Neurotech-Hub/ACORN/brand/ANCORN_render_back.png

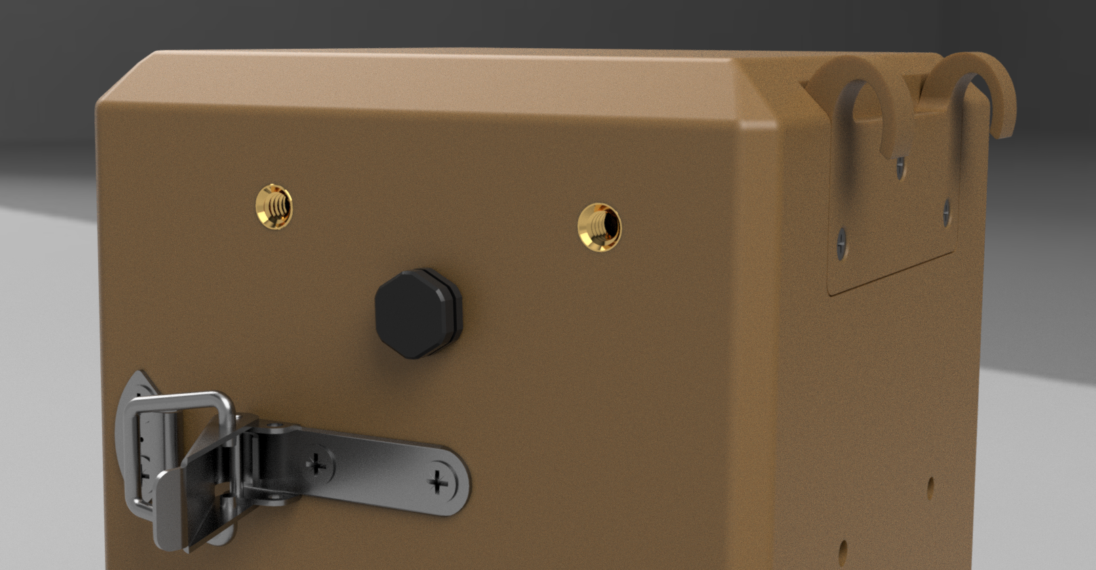
brand/ANCORN_render_back.png
