Neurotech-Hub/ACORN/brand/ACORN_iphone_rustic_mockup.jpg

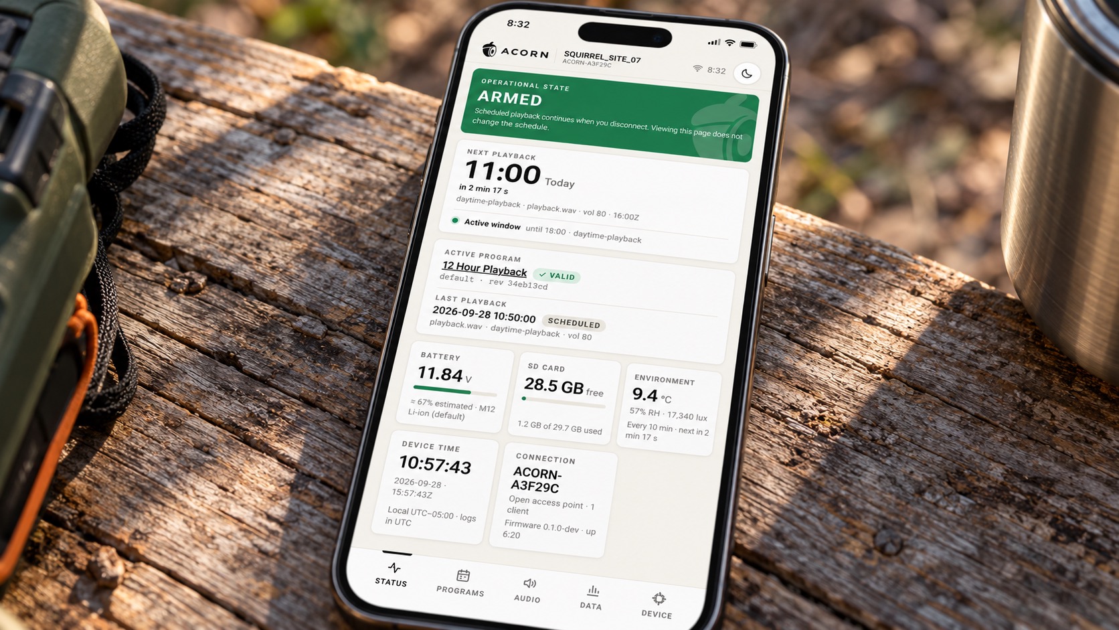
brand/ACORN_iphone_rustic_mockup.jpg
