Neurotech-Hub/ACORN/docs/assets/acorn-spl-levels.pdf

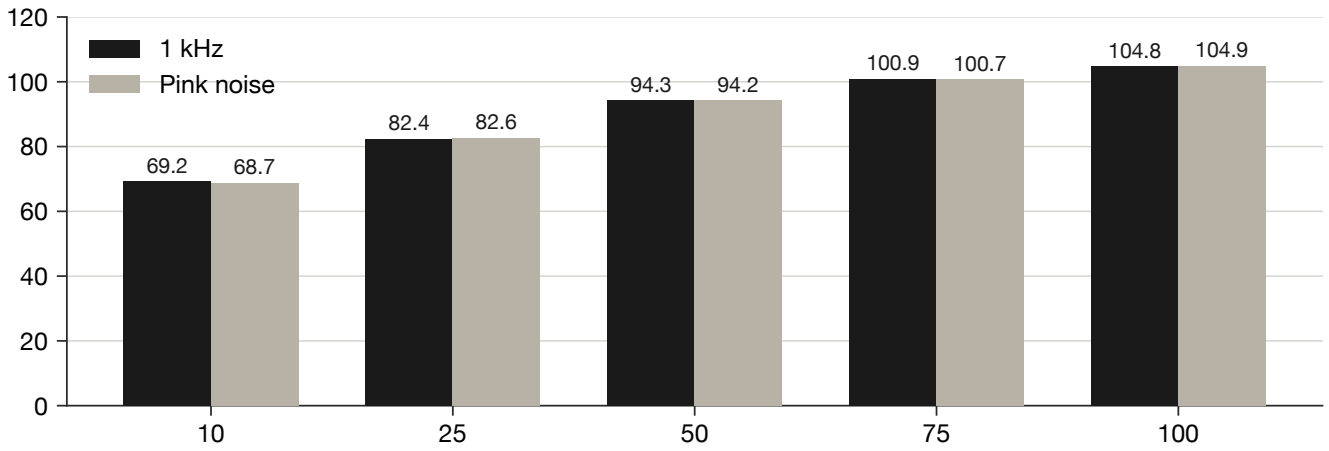
[picture p3: figure]
1 kHz Pink noise

## Volume

## Maximum SPL (dB)

## ACORN | Sound Pressure Level
