Neurotech-Hub/ACORN/brand/ACORN_brandKit.png

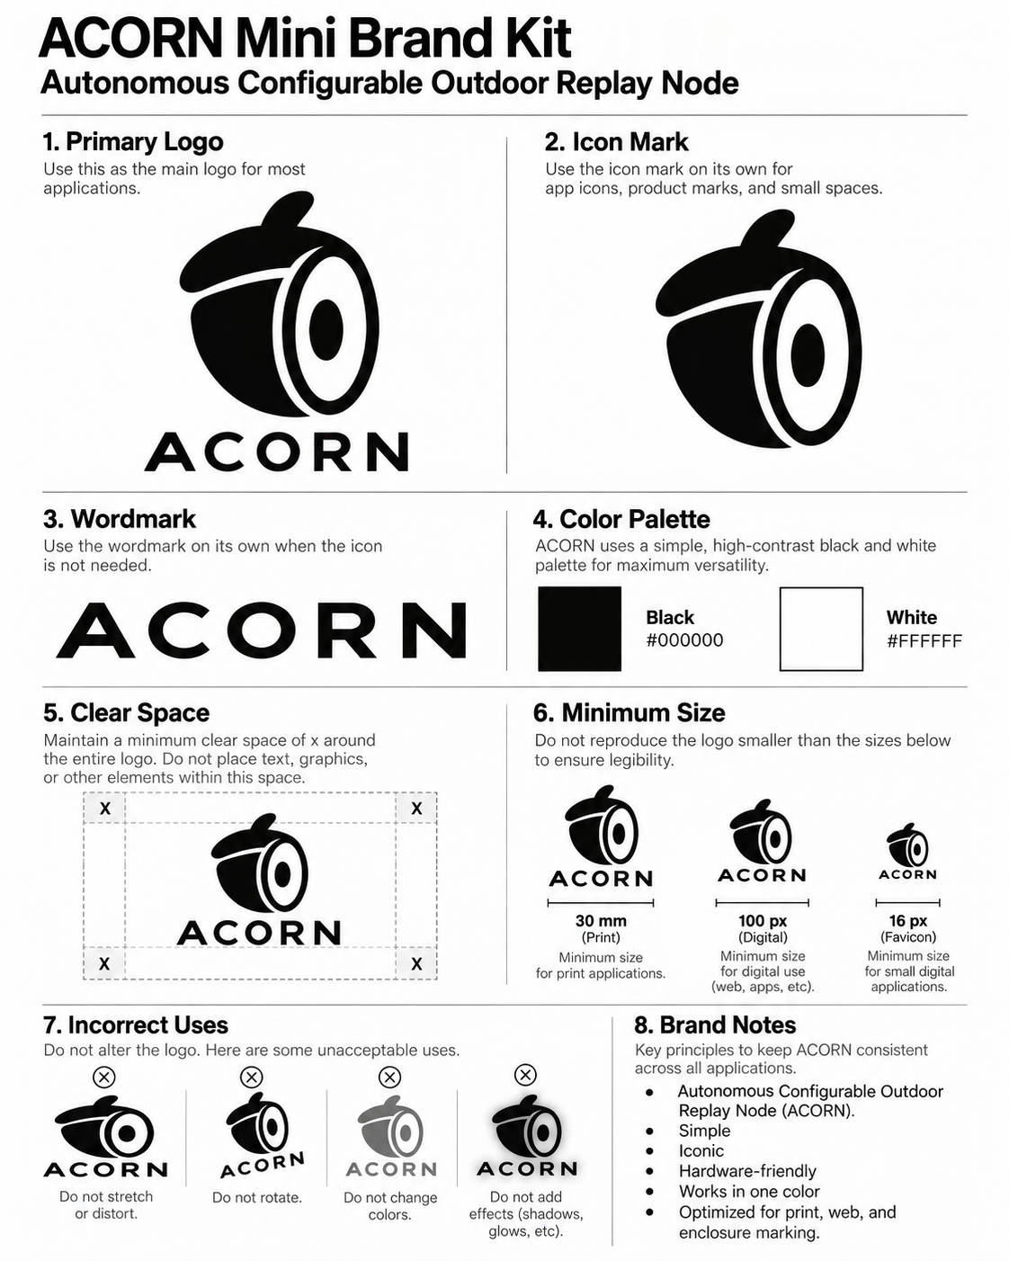
brand/ACORN_brandKit.png
