Neurotech-Hub/ACORN/brand/ACORN_iphone_mockup.jpg

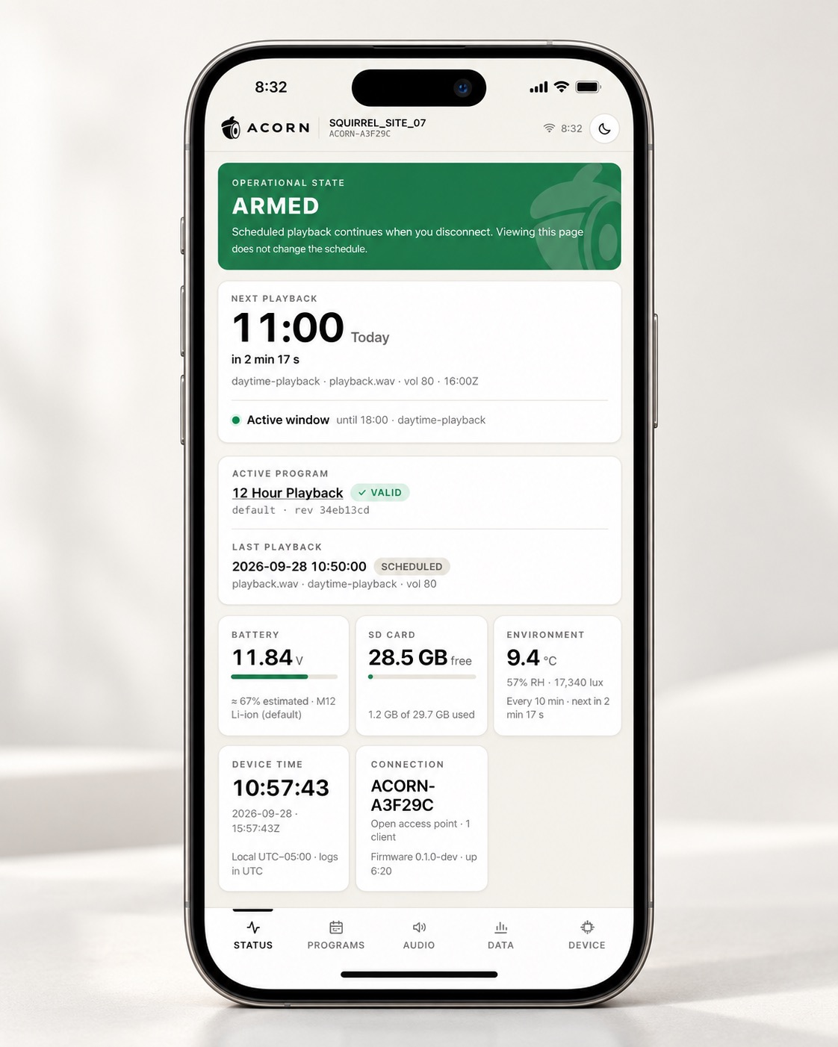
brand/ACORN_iphone_mockup.jpg
