Neurotech-Hub/ACORN/brand/ACORN_iphone_treemount_mockup.jpg

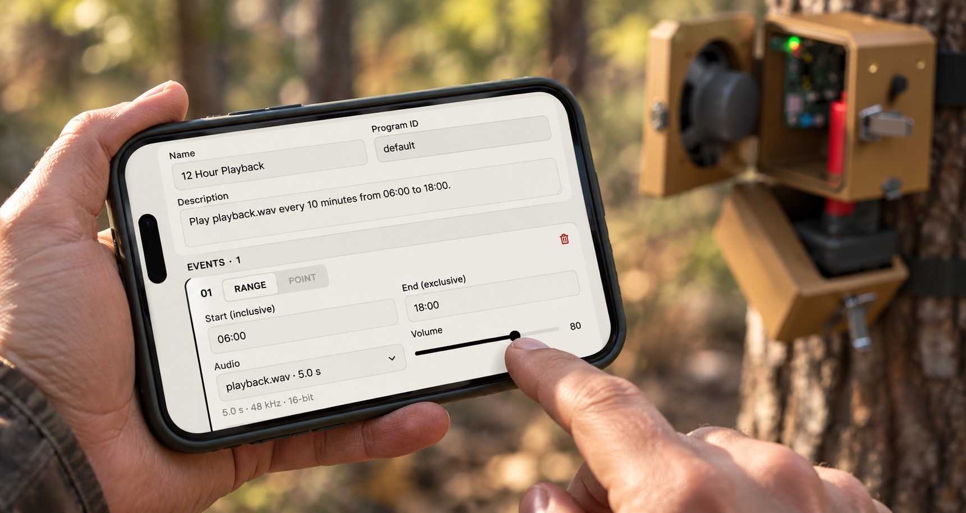
brand/ACORN_iphone_treemount_mockup.jpg
