Neurotech-Hub/ACORN/brand/ACORN_macbook_mockup.jpg

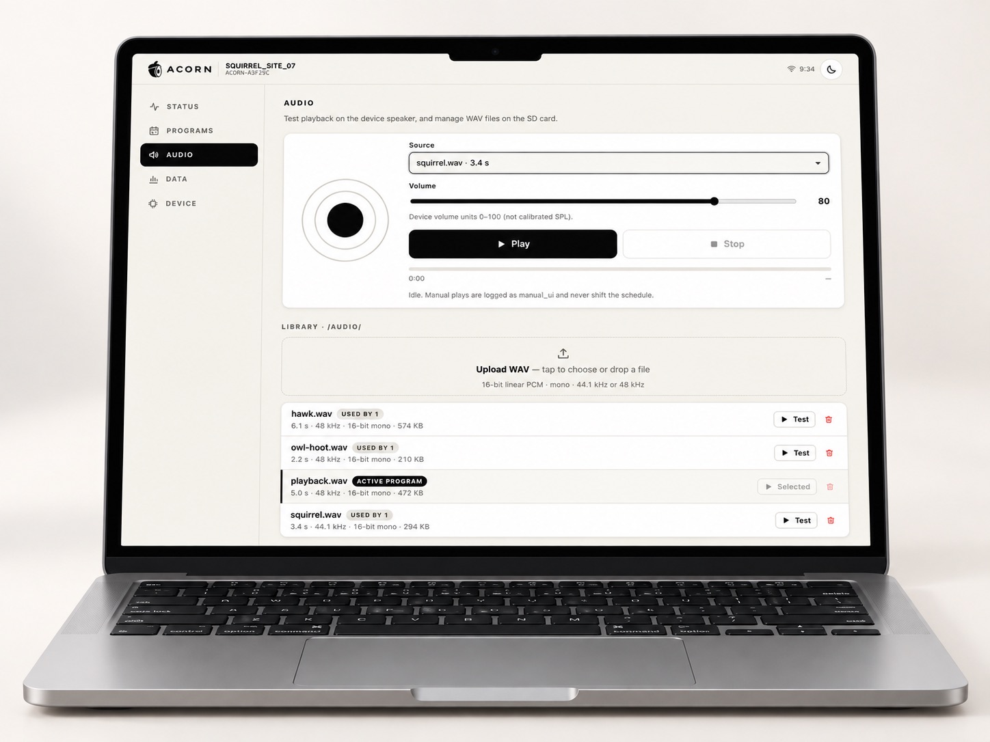
brand/ACORN_macbook_mockup.jpg
