Neurotech-Hub/ACORN/brand/ACORN_render_front.png

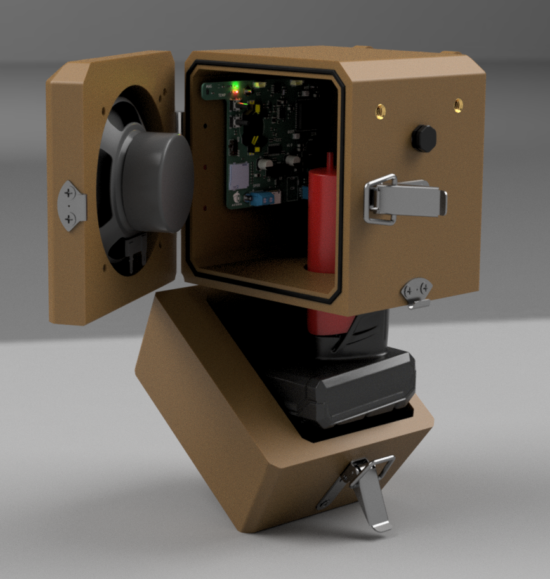
brand/ACORN_render_front.png
