Neurotech-Hub/ACORN/docs/assets/acorn-frequency-response.png

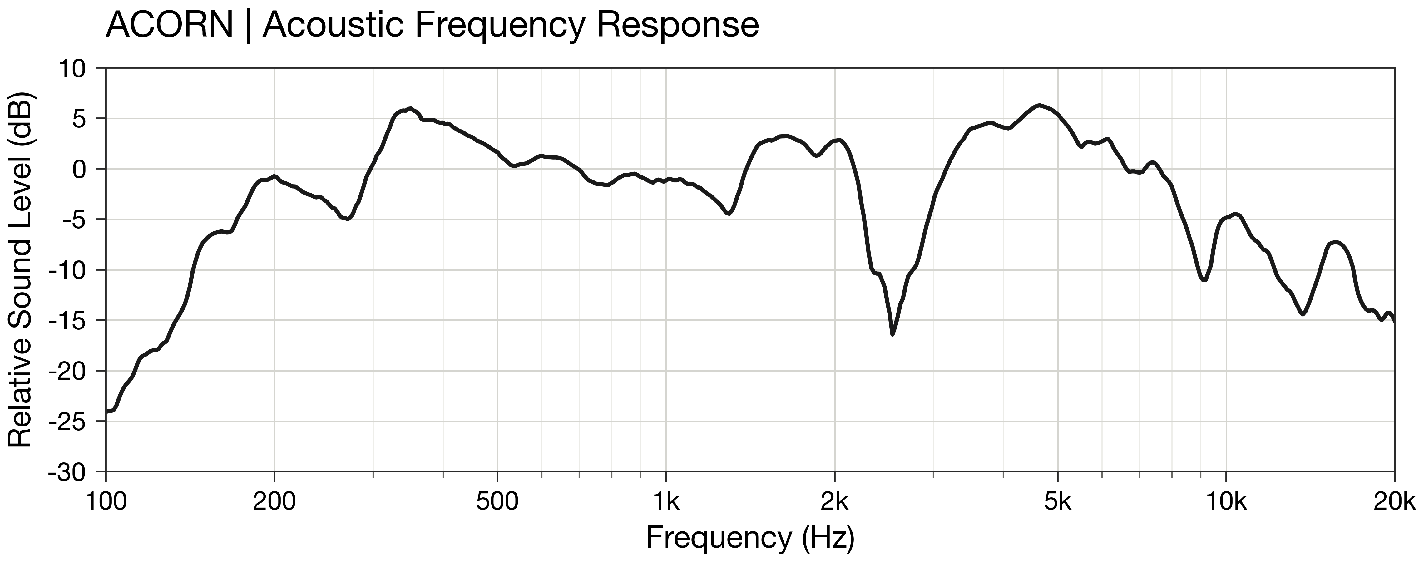
docs/assets/acorn-frequency-response.png
