Neurotech-Hub/ACORN/docs/assets/acorn-spl-levels.png

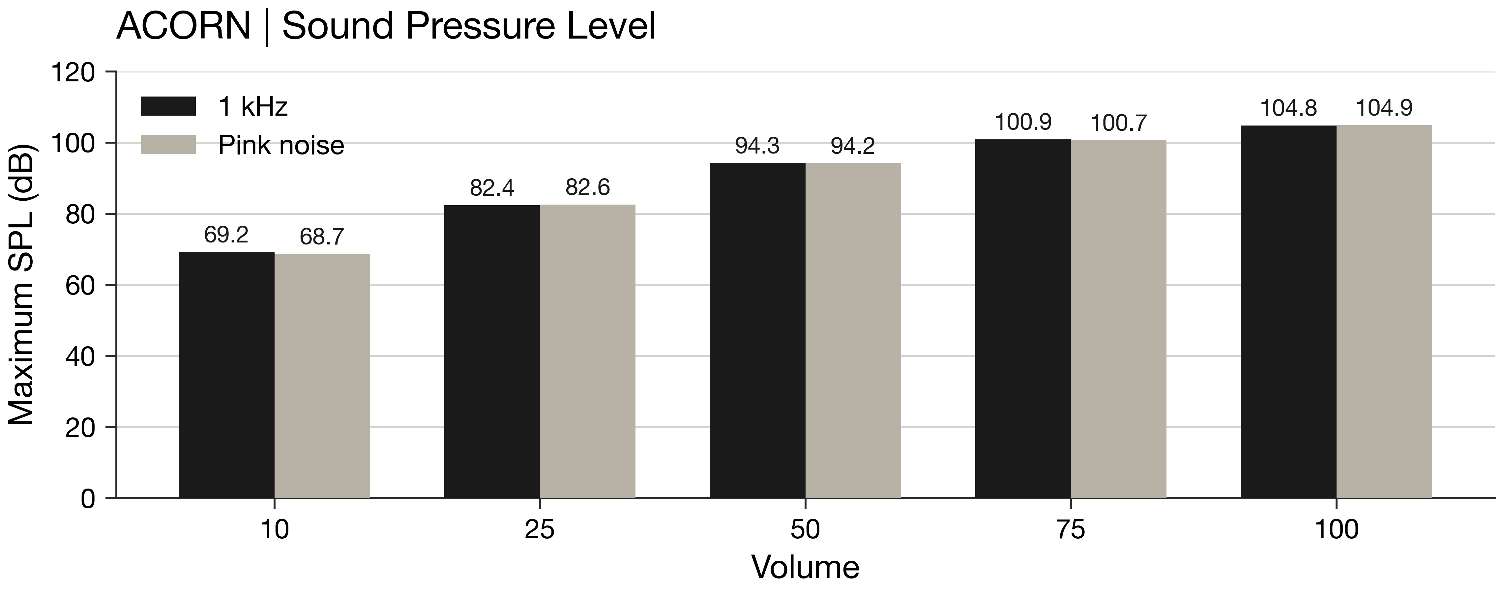
docs/assets/acorn-spl-levels.png
