Neurotech-Hub/ACORN/docs/sweep/media/mg-2026-10-28-12.03.54_v75.png

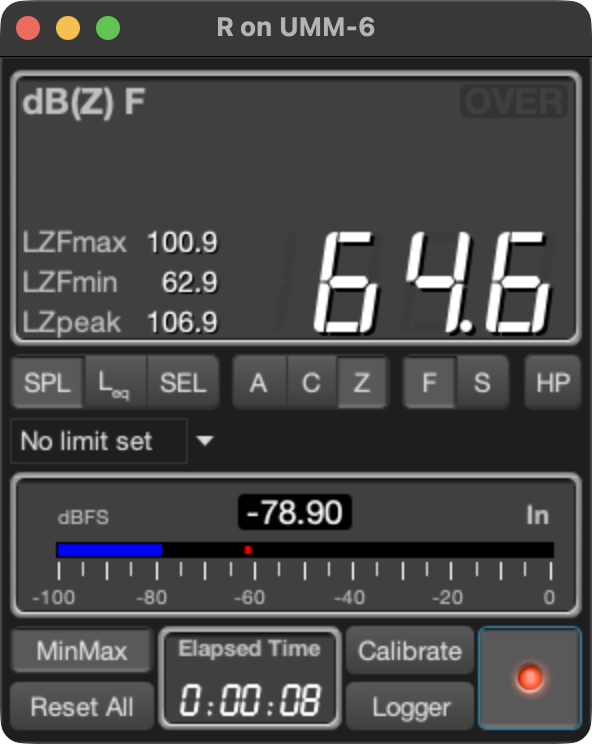
docs/sweep/media/mg-2026-10-28-12.03.54_v75.png
