Neurotech-Hub/ACORN/docs/sweep/media/mg-2026-10-28-12.04.52_v25.png

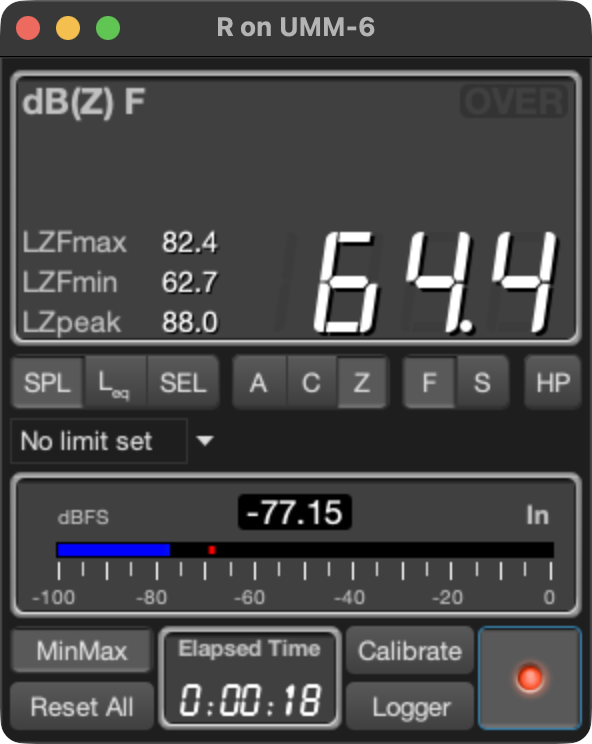
docs/sweep/media/mg-2026-10-28-12.04.52_v25.png
