Neurotech-Hub/ACORN/docs/sweep/media/mg-2026-10-28-12.07.01_pink_v10.png

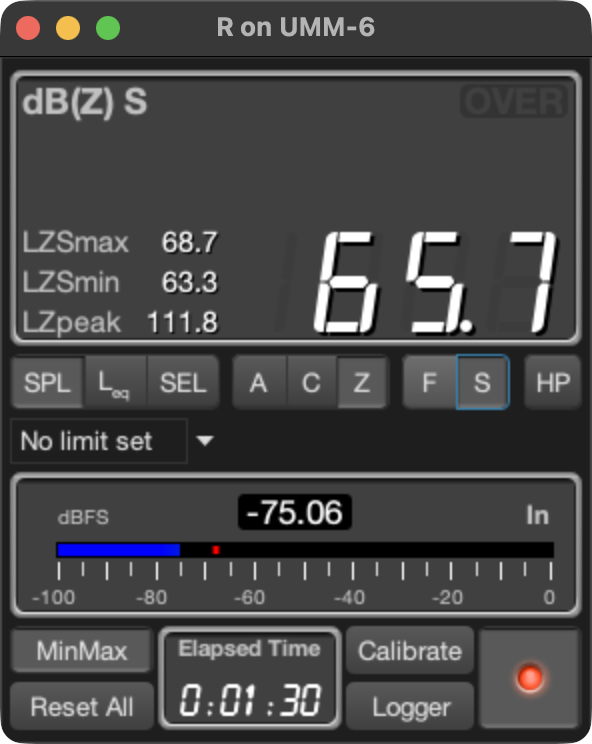
docs/sweep/media/mg-2026-10-28-12.07.01_pink_v10.png
