Neurotech-Hub/ACORN/docs/sweep/media/mg-2026-10-28-12.07.39_pink_v25.png

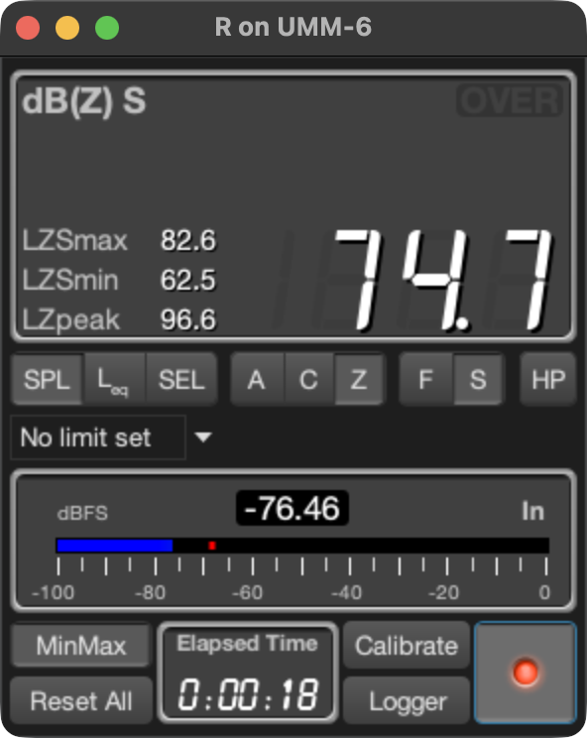
docs/sweep/media/mg-2026-10-28-12.07.39_pink_v25.png
