Neurotech-Hub/ACORN/docs/sweep/media/mg-2026-10-28-12.08.13_pink_v50.png

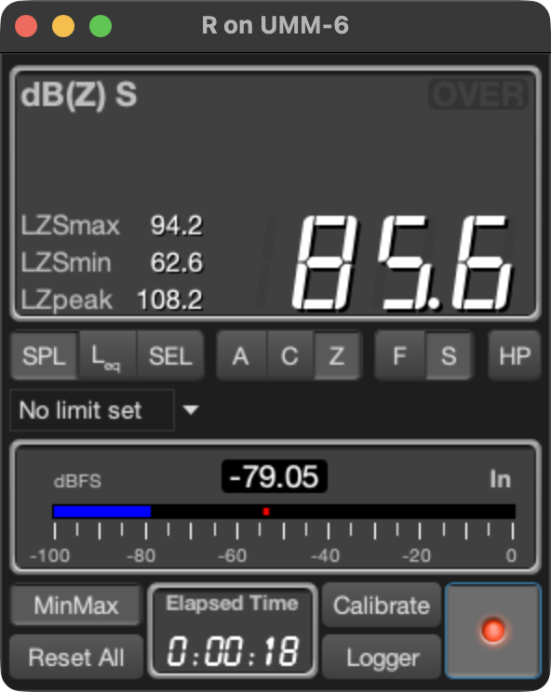
docs/sweep/media/mg-2026-10-28-12.08.13_pink_v50.png
