Neurotech-Hub/ACORN/hardware/ACORN_v1-0.step

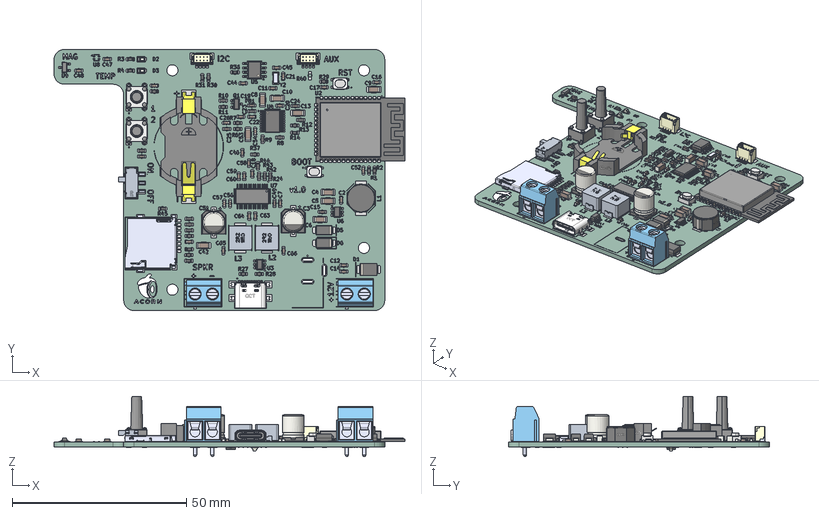
[picture p18: CAD file, 2026-10-19]
hardware/ACORN_v1-0.step
100.8 x 75.0 x 17.4 mm
C_0603_1608Metric x 37
CUI_DEVICES_TS02-66-130-BK-100-SCR-D x 2
R_0603_1608Metric x 35
TSOT-23-6
LED_0603_1608Metric x 3
SOT-23
C_1206_3216Metric x 9
SW-SMD_4P-L4.2-W3.2-P2.15-LS4.5 x 2
I2C-Connector x 2
SOIC-8_3.9x4.9mm_P1.27mm
BAT-SMD_BS06A3B0A006
CP_Elec_6.3x7.7 x 2
ECS-.327-7-34R-TR
D_SMA x 2
Same_Sky_MSD-1-A
JS102011SAQN
TB002-500-02P_Blue - S x 2
D_SMB
SOT-23-6
SRP7050TA-100M x 2
BODY-SOT
LEAD-SOT x 3
PIN1-ID
TIEBAR
TPA3138D2PWPR
USB4110-GF-A_revB(1) MF
ESP32-S3-WROOM-1
IND-SMD_L8.0-W8.0-YPRH8D43-101M
TSSOP-20_4.4x6.5mm_P0.65mm
ACORN_v1-0_pad
ACORN_v1-0_silkscreen x 2
ACORN_v1-0_PCB
