Neurotech-Hub/ACORN/docs/assets/acorn-frequency-response.pdf

## ACORN | Acoustic Frequency Response

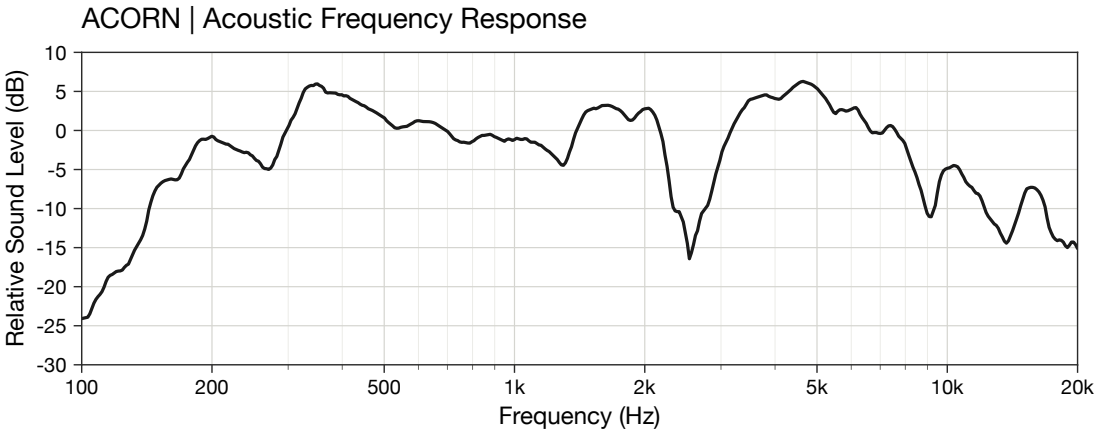
[picture p19: page 1]
Frequency (Hz)

Relative Sound Level (dB)
