Neurotech-Hub/ACORN/arduino/acorn/src/power/SleepManager.cpp

#include "SleepManager.h"

#include <AcornHardware.h>

#include "../audio/PlaybackService.h"
#include "../services/LedService.h"
#include "../services/TimeService.h"
#include "../state/DeviceState.h"

namespace acorn {
namespace SleepManager {

namespace {

// Section 42 steps 2-5: audio, SD, Wi-Fi and LEDs into their safe states.
void shutDownPeripherals() {
  AudioHardware::prepareForSleep();
  SdHardware::unmount();
  SdHardware::prepareForSleep();
  WifiApHardware::stop();
  LedService::prepareForSleep();
}

}  // namespace

WakePlanner::Wake nextWake(int64_t nowUtc) {
  ScheduledEvent next;
  const int64_t playback = DeviceState::nextPlayback(nowUtc, next) ? next.utc : WakePlanner::NONE;
  const int64_t env = DeviceState::nextEnvSample(nowUtc);
  return WakePlanner::earliest(playback, env < 0 ? WakePlanner::NONE : env);
}

bool wakeTooClose(int64_t nowUtc) {
  const WakePlanner::Wake wake = nextWake(nowUtc);
  return wake.reason != WakePlanner::Reason::None && wake.utc - WAKE_LEAD_S - nowUtc < MIN_SLEEP_S;
}

void onTimeChanged() {
  RtcHardware::disableAlarm();
  RtcHardware::clearAlarmFlag();
}

bool enter(String& reason) {
  const int64_t now = TimeService::nowUtc();
  const WakePlanner::Wake wake = nextWake(now);
  if (wakeTooClose(now)) {
    reason = "next event is too close to sleep";
    return false;
  }

  // Section 42 steps 1-9.
  PlaybackService::stop();
  shutDownPeripherals();

  // Steps 10-11.
  RtcHardware::clearAlarmFlag();
  SleepConfig cfg;
  cfg.hallWakeOnClose = true;
  if (wake.reason == WakePlanner::Reason::None || !TimeService::isValid()) {
    RtcHardware::disableAlarm();
    cfg.wakeOnRtcAlarm = false;
  } else if (!RtcHardware::setAlarm(UtcTime::fromEpoch(wake.utc - WAKE_LEAD_S))) {
    cfg.wakeOnRtcAlarm = false;
  }

  Serial.printf("sleep: next wake %s (%s)%s\n",
                wake.reason == WakePlanner::Reason::None ? "none" : TimeService::isoUtc(wake.utc).c_str(),
                wake.reason == WakePlanner::Reason::Playback    ? "playback"
                : wake.reason == WakePlanner::Reason::EnvSample ? "env sample"
                                                                : "buttons/door only",
                HallHardware::isDoorOpen() ? ", door open: wake on close" : "");
  Serial.flush();

  // Step 12. Returns only if no wake source could be armed.
  const SleepArmResult r = SleepHardware::enter(cfg);
  reason = r.anyArmed() ? "sleep entry failed" : "no wake source could be armed";
  return false;
}

bool enterCritical(String& reason) {
  shutDownPeripherals();
  // No schedule alarm: a dense schedule would otherwise wake (and boot) the
  // device at every event even though nothing may run. Door, buttons and a
  // slow timer re-check are the only wake sources.
  RtcHardware::disableAlarm();
  RtcHardware::clearAlarmFlag();
  SleepConfig cfg;
  cfg.hallWakeOnClose = true;
  cfg.wakeOnRtcAlarm = false;
  cfg.timerUs = static_cast<uint64_t>(CRITICAL_RECHECK_S) * 1000000ULL;
  Serial.printf("sleep: battery critical, buttons/door only, re-check in %d min%s\n",
                static_cast<int>(CRITICAL_RECHECK_S / 60), HallHardware::isDoorOpen() ? ", door open: wake on close" : "");
  Serial.flush();
  const SleepArmResult r = SleepHardware::enter(cfg);
  reason = r.anyArmed() ? "sleep entry failed" : "no wake source could be armed";
  return false;
}

}  // namespace SleepManager
}  // namespace acorn
