Neurotech-Hub/ACORN/(commit log)

2026-09-27 Phase 1: configuration UI skeleton with mock device
    - web/: dependency-free static UI (Status, Programs, Audio, Data, Device),
    light/dark themes, phone-first layout, ~44 KB gzipped
    - dev/: zero-dependency dev server with mock /api/v1, simulated latency,
    WAV/firmware upload inspection, and fault scenarios (/__dev)
    - tools/build-web.mjs: gzip assets and generate web_assets.h for firmware
    - brand/svg/: vectorized logo, icon mark and wordmark
    - docs/web-ui.md: dev workflow, API contract, firmware porting guide
2026-09-28 Phases 2-4: hardware layer, core application, integration
    Phase 2: AcornHardware HAL (RTC, SD, audio chain, battery, SHT40,
    VEML6031, LEDs, buttons, Hall, Wi-Fi AP, deep sleep, OTA) with one
    isolated test sketch per component and compile-tests.sh.
    Phase 3: AcornCore (pure C++17: scheduler, validator, program JSON and
    revision, env schedule, battery model, wake planner, CSV, UTC time) with
    host unit tests and golden previews shared with the mock; vendored
    ArduinoJson 7.4.2; firmware services and the /api/v1 layer on the core
    WebServer; API contract test (tools/api-contract.mjs).
    Phase 4: event-driven wake/work/sleep runtime (RTC alarm 2 s early,
    playback at the scheduled second, markers kep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
    [partitions.csv]
2026-09-28 AMP_SHDN: high-Z = off via 100k pulldown, drive HIGH = on
    The board has a 5.1k series resistor from GPIO38 to TPA3138D2 SD/FAULT
    and a 100k pulldown on SD/FAULT. The previous open-drain "release for
    HIGH" drive assumed a pull-up and would have left the amp shut down.
    - OFF = INPUT (pulldown holds SD/FAULT LOW, also during boot/reset/sleep)
    - ON = OUTPUT HIGH
    - Deep sleep: AMP_SHDN left high-Z instead of latched LOW; begin() clears
    any hold left by older firmware
    - ampFaulted() always false: GPIO38 reads back its own drive through the
    series resistor, so amp faults are not observable; test_audio no longer
    reports fault checks
    - docs/hardware.md, READMEs updated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
    [test_audio.ino]
2026-10-19 Correct the switched 3.3 V rail polarity and fold board bring-up into one sketch.
    Add a browser audio converter for GitHub Pages and check in the v1 enclosure model.
    [ACORN_v1-0.step]
2026-10-19 Wait for the RTC oscillator before marking a clock sync invalid.
    OSCRUN lags the start bit, so an immediate check left rtc_valid false while the software clock was already set.
    [TimeService.cpp]
2026-10-20 Add Try demo to the audio converter with a goshawk sample
    A muted control in the Source file card loads a bundled northern
    goshawk call so visitors can try the converter without picking a file.
2026-10-20 Keep due events from sleeping and lock the battery model to a live plot.
    Stay awake when a scheduled event is pending, add program deactivate, blink
    LED_G until a Wi-Fi client connects, and replace the editable curve with a
    fixed 12 V = 100% model plus a discharge plot on the Device page.
    [LedService.cpp, LedService.h, Runtime.cpp]
2026-10-20 Drop the redundant page subtitles on Programs, Audio, Data, and Device.
2026-10-24 Document the site lat/long plan in the README. (#1)
    Locks the design for /config/site.json plus latitude/longitude columns on
    playback and environment CSVs, with Device UI capture deferred to execution.
2026-10-24 Stamp each log row with the device's site location so a deployment can be placed later.
    Also pin the Programs save bar so the keyboard no longer covers it, and add a Log Plotter for the playback and environment CSVs.
    [AppConfig.h]
2026-10-28 Add an ignore-magnet override and keep the iPhone keyboard off the form.
    Closing the enclosure no longer ends a session when the developer toggle is on, and form fields stay large enough that Safari does not zoom or leave the bars over the field being edited.
    [Runtime.cpp]
2026-10-28 Plot the calibrated auditorium sweeps and the volume sound-pressure levels.
    Average the three UMM-6 sweeps after microphone correction, and add the 1 kHz and pink-noise levels at each volume setting.
2026-11-02 Indicate a missing SD with the red LED and make log clearing usable in the field.
    Solid red while unmounted, refresh SD-backed pages on remount, and add a confirmed Clear memory action on each Data log card.
    [LedService.cpp, LedService.h]
2026-11-02 Gate amp, radio and SD behind a critical-battery threshold so a near-dead pack cannot brown the device out.
    Below 8 V the device blinks fast for a person at the door or buttons, skips logging and schedule wakes, and sleeps with only door, button and a 30 min re-check armed.
    [AppConfig.h, LedService.cpp, LedService.h, Runtime.cpp, SleepManager.cpp, SleepManager.h]
